autobleem2/ableemstation/files/stickers/special/ableemstation-stickers-A4.pdf

ABleemStation stickers - print at 100% (no "fit to page"), vinyl sticker sheet; cut on the dashed lines. Check: the top plate must measure 61 mm.

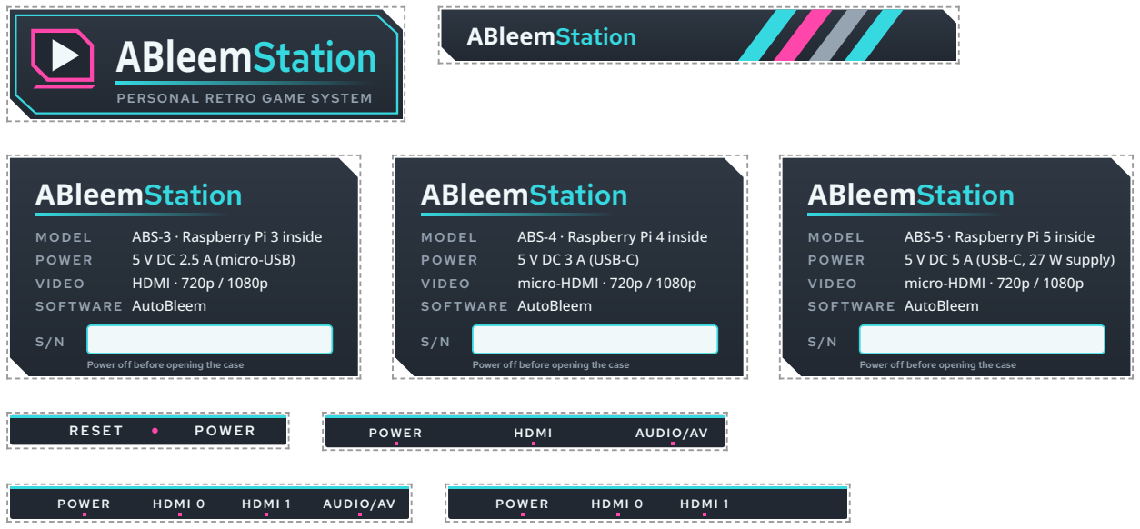
[picture p5: figure]
ABleemStation; PERSONAL RETRO GAME SYSTEM; ABS-3 · Raspberry Pi 3 inside; P OWER; 5 V DC 2.5 A (micro-USB); HDMI · 720p / 1080p; S O FTWA RE AutoBleem; Power off before opening the case; ABS-4 · Raspberry Pi 4 inside; 5 V DC 3 A (USB-C); micro-HDMI · 720p / 1080p; ABS-5 · Raspberry Pi 5 inside; 5 V DC 5 A (USB-C, 27 W supply); POWER; HDMI; AUDIO/AV; HDMI 0; HDMI 1

# ABleemStation

SPECIAL EDITION · RETRO GAME SYSTEM

## ABleemStation

# ABleemStation

M O D EL | ABS-3 · Raspberry Pi 3 inside
P OWER | 5 V DC 2.5 A (micro-USB)
V I D EO | HDMI · 720p / 1080p
S O FTWA RE AutoBleem

S/N

Power off before opening the case

# ABleemStation

M O D EL | ABS-4 · Raspberry Pi 4 inside
P OWER | 5 V DC 3 A (USB-C)
V I D EO | micro-HDMI · 720p / 1080p
S O FTWA RE AutoBleem

S/N

Power off before opening the case

# ABleemStation

M O D EL | ABS-5 · Raspberry Pi 5 inside
P OWER | 5 V DC 5 A (USB-C, 27 W supply)
V I D EO | micro-HDMI · 720p / 1080p
S O FTWA RE AutoBleem

S/N

Power off before opening the case

RE S E T | P OW ER | POWER | HDMI | AUDIO/AV
POWER | HDMI 0 | HDMI 1 | AUDIO/AV | POWER | HDMI 0 | HDMI 1
