autobleem2/ableemstation/files/renders/1-iso.png

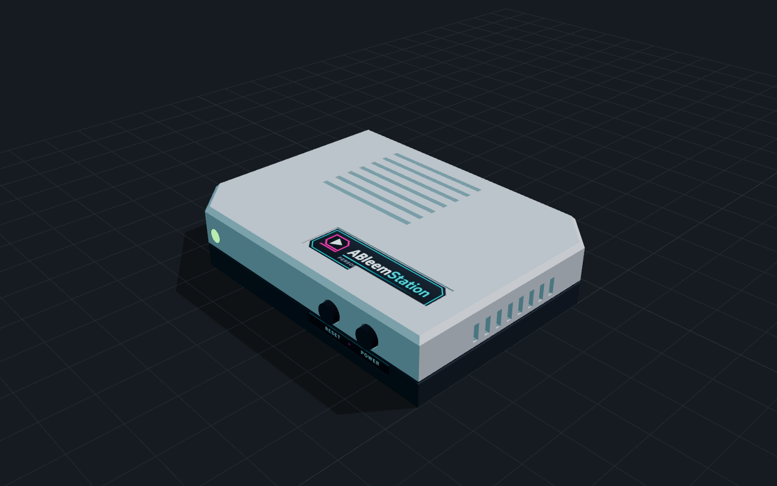
files/renders/1-iso.png
