autobleem2/ableemstation/files/renders/2-front.png

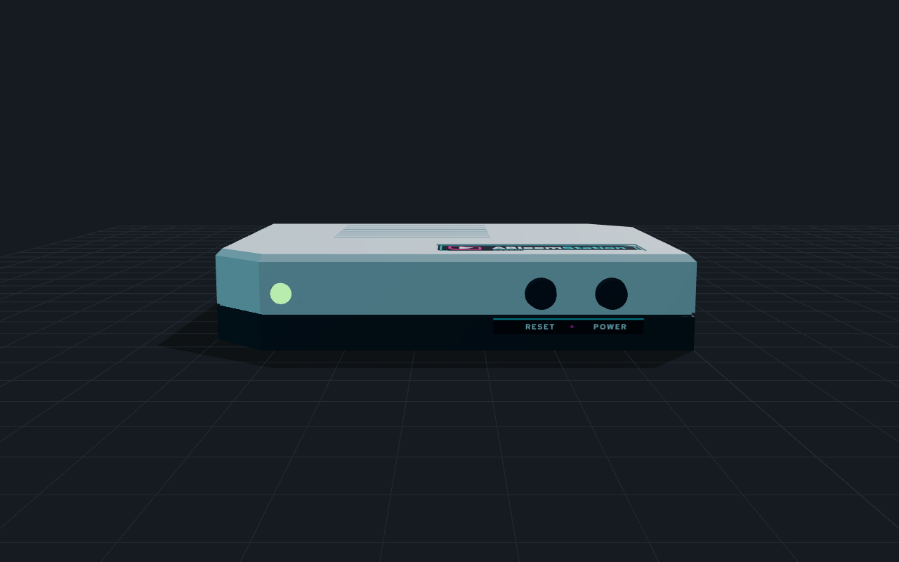
files/renders/2-front.png
