autobleem2/ableemstation/files/renders/4-right.png

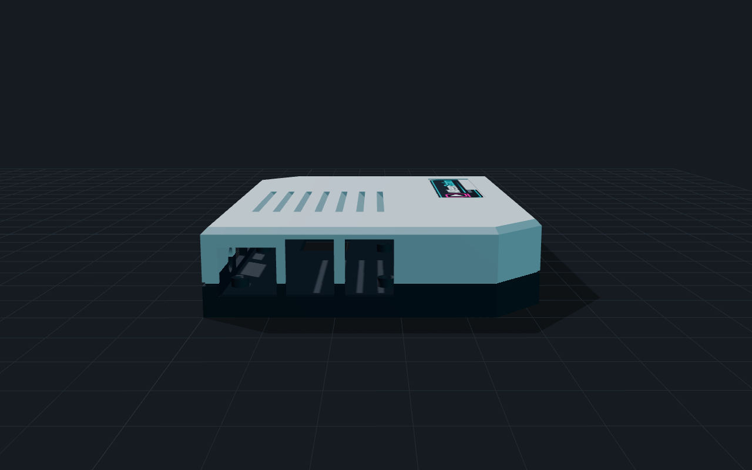
files/renders/4-right.png
