autobleem2/ableemstation/files/renders/5-exploded.png

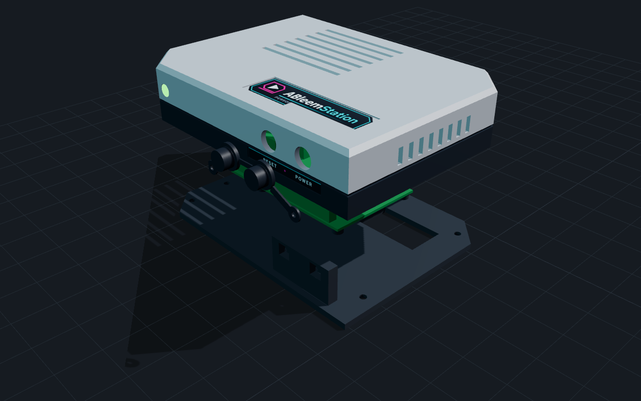
files/renders/5-exploded.png
