autobleem2/ableemstation/files/renders/6-xray.png

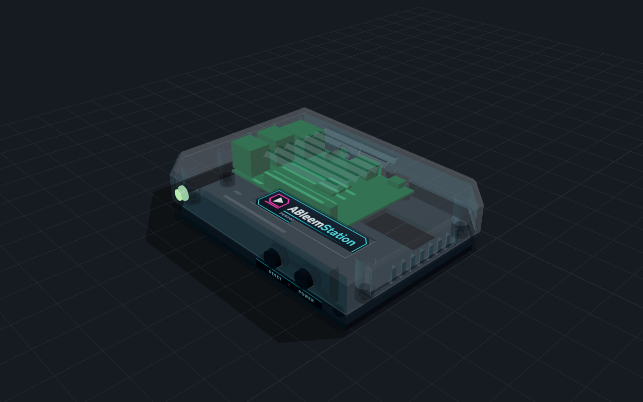
files/renders/6-xray.png
