autobleem2/ableemstation/files/renders/colors/graphite.png

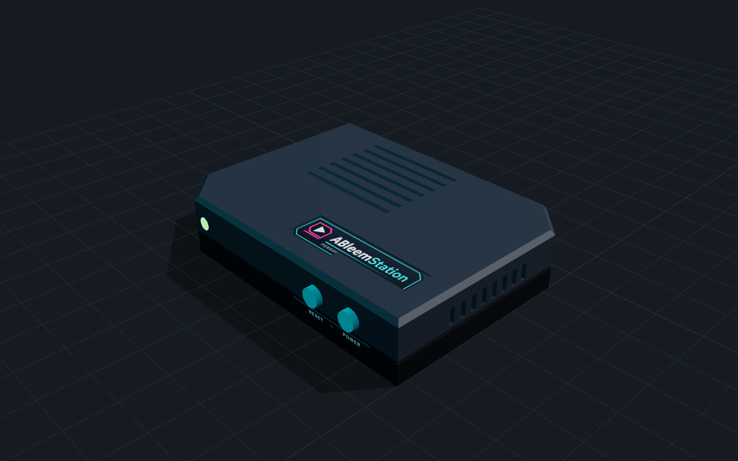
files/renders/colors/graphite.png
