autobleem2/ableemstation/files/renders/colors/midnight.png

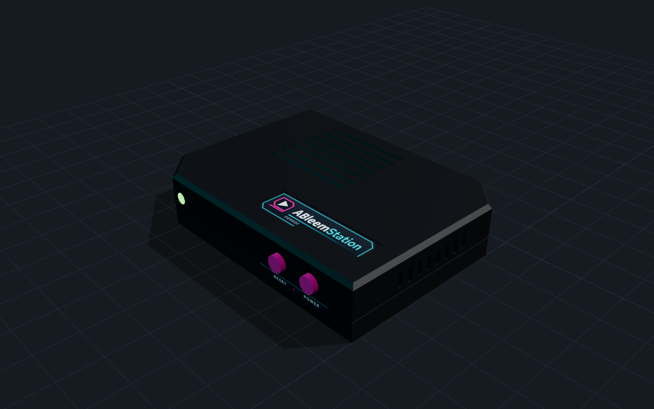
files/renders/colors/midnight.png
