autobleem2/ableemstation/files/renders/colors/mint.png

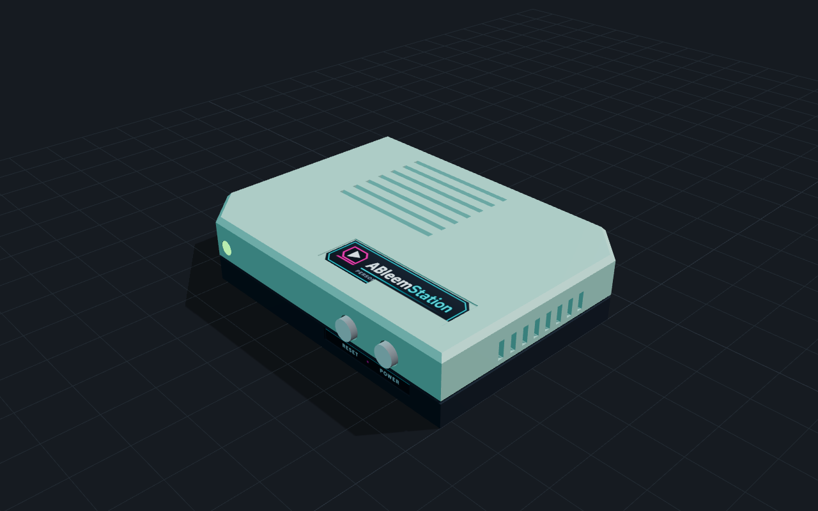
files/renders/colors/mint.png
