autobleem2/ableemstation/files/stickers/cricut-144dpi/ableemstation-all-stickers.png

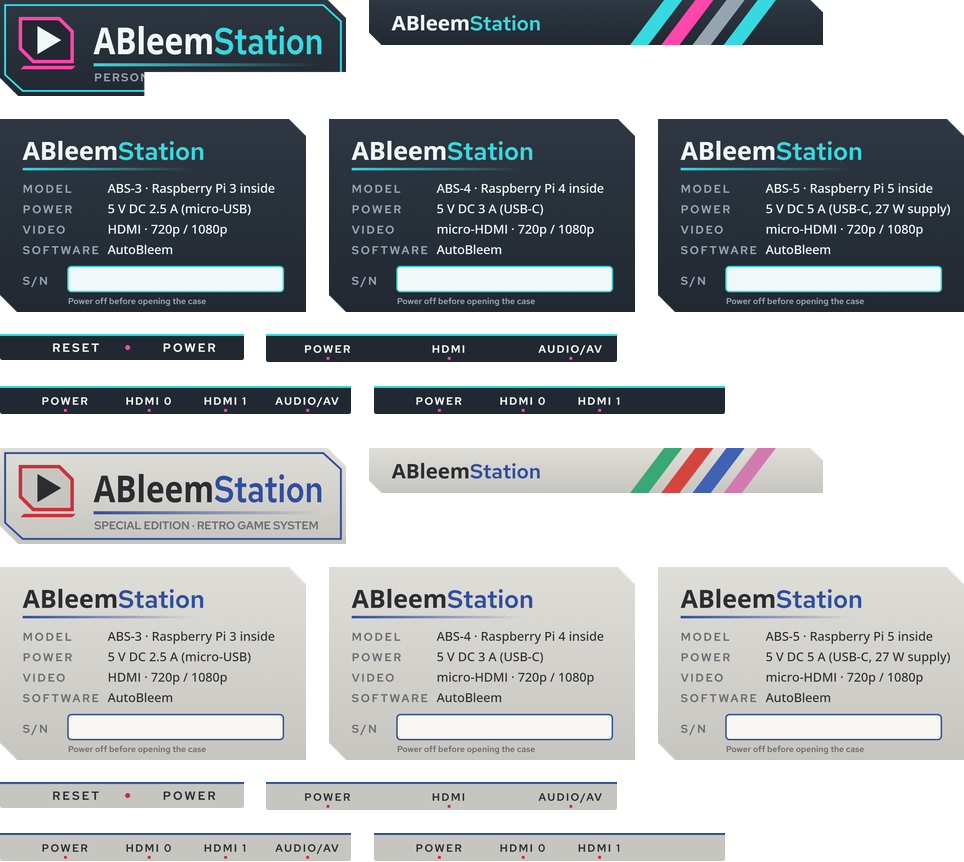
files/stickers/cricut-144dpi/ableemstation-all-stickers.png
