autobleem2/ableemstation/files/stickers/sticker-top.png

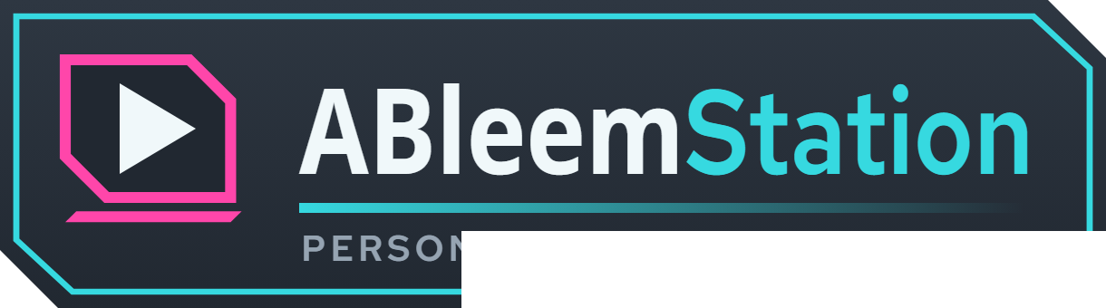
files/stickers/sticker-top.png
