autobleem2/ableemstation/files/universal/renders/8-exploded.png

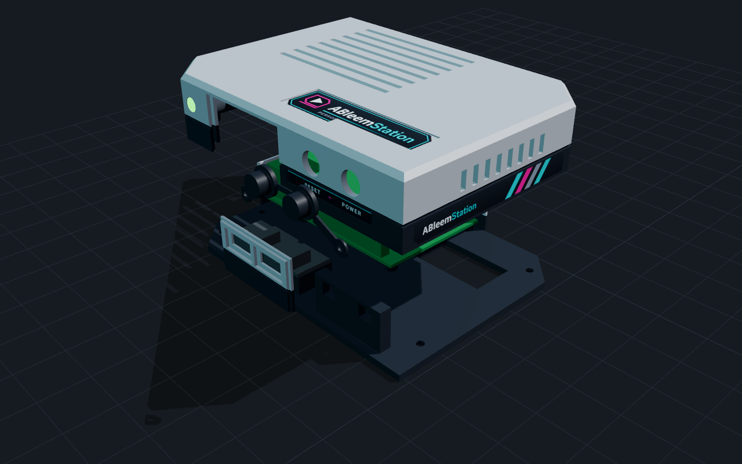
files/universal/renders/8-exploded.png
