autobleem2/ableemstation/files/universal/renders/10-top-active.png

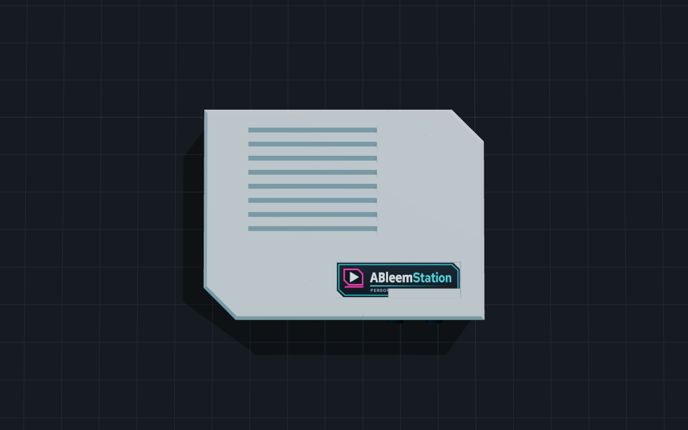
files/universal/renders/10-top-active.png
