autobleem2/ableemstation/files/universal/renders/12-bottom-sticker.png

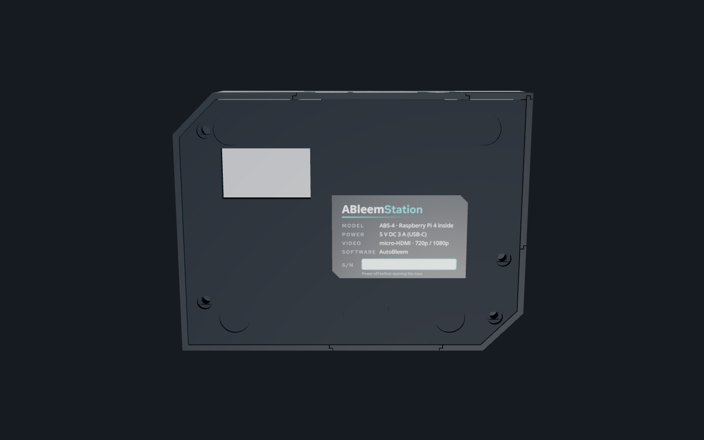
files/universal/renders/12-bottom-sticker.png
