autobleem2/ableemstation/files/universal/sticker-placement.png

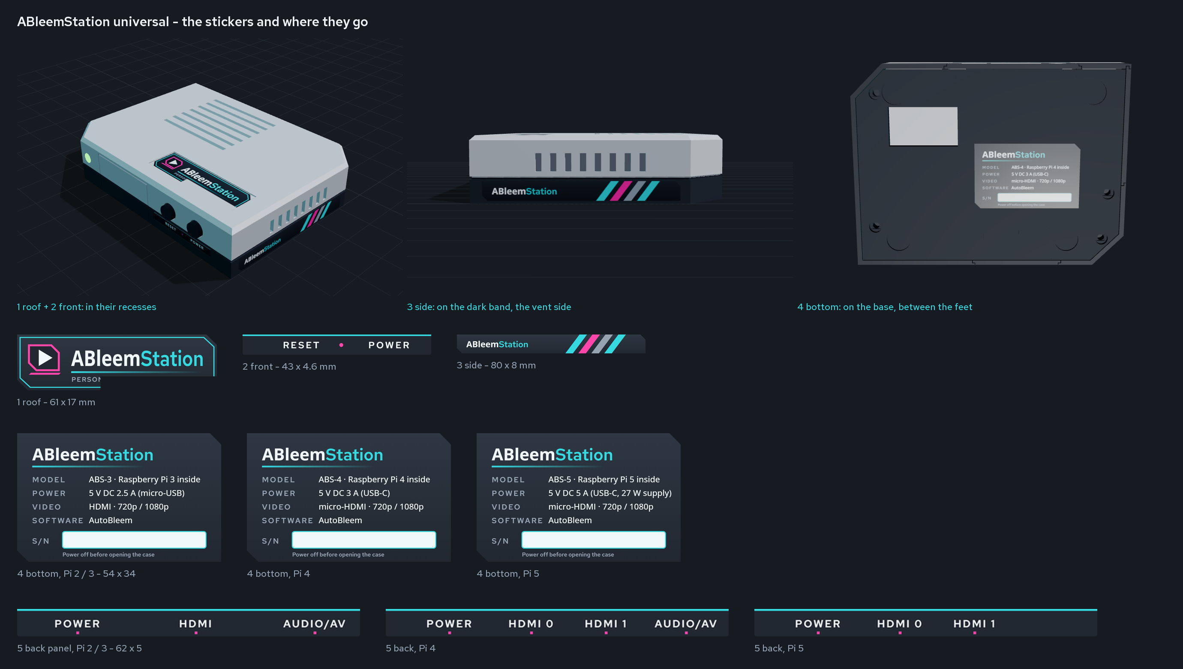
files/universal/sticker-placement.png
