autobleem2/ableemstation/files/ableemstation-assembly.step

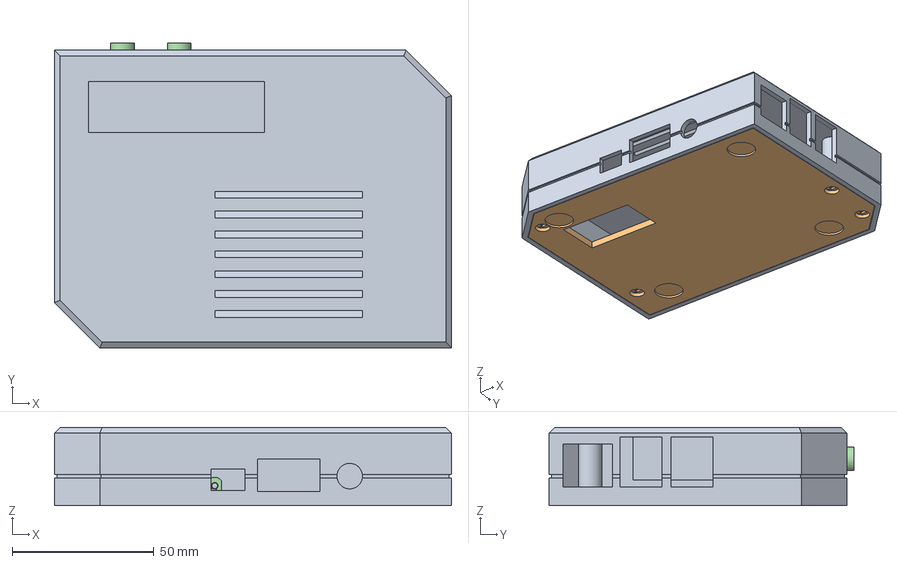
[picture p20: CAD file, 2026-10-09]
files/ableemstation-assembly.step
140.0 x 107.5 x 27.6 mm
