autobleem2/ableemstation/files/universal/ableemstation-uni-shell-active.step

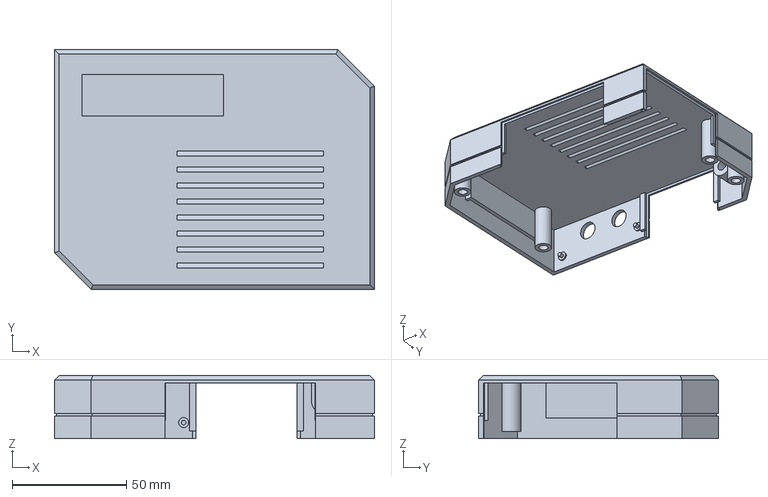
[picture p22: CAD file, 2026-10-09]
files/universal/ableemstation-uni-shell-active.step
140.0 x 105.0 x 27.6 mm
