autobleem2/ableemstation/files/universal/viewer/base.stl

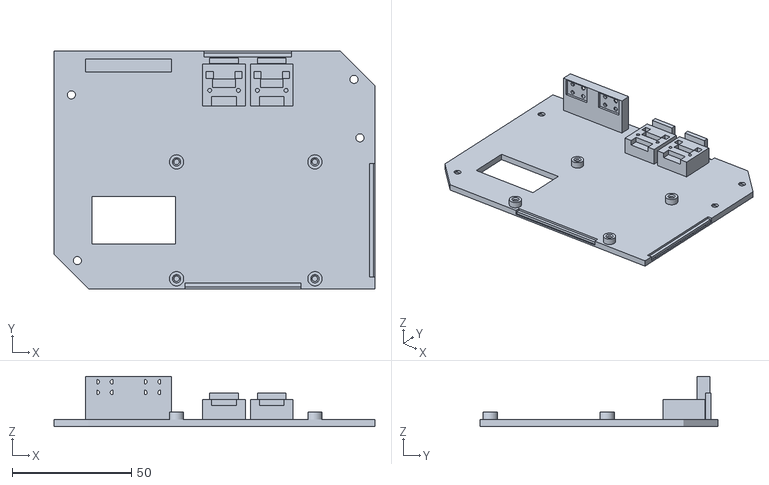
[picture p23: CAD file, 2026-10-09]
files/universal/viewer/base.stl
134.6 x 99.6 x 21.0
