autobleem2/ableemstation/files/viewer/base.stl

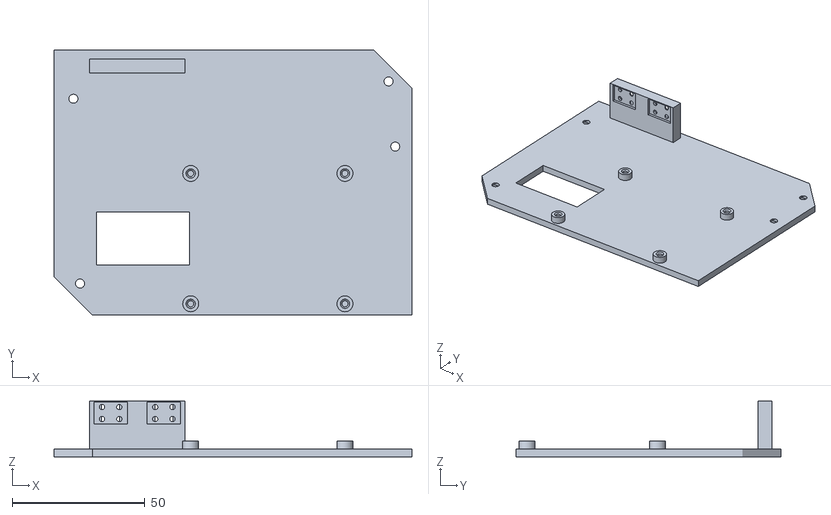
[picture p24: CAD file, 2026-10-09]
files/viewer/base.stl
134.6 x 99.6 x 21.0
