autobleem2/ableemstation/files/universal/ableemstation-panel-right-pi4-front.step

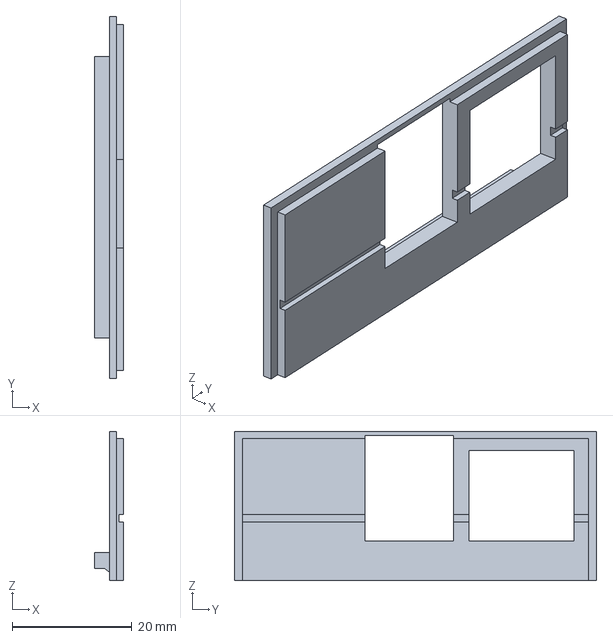
[picture p25: CAD file, 2026-10-09]
files/universal/ableemstation-panel-right-pi4-front.step
4.90 x 60.5 x 24.9 mm
