autobleem2/ableemstation/files/viewer/shell.stl

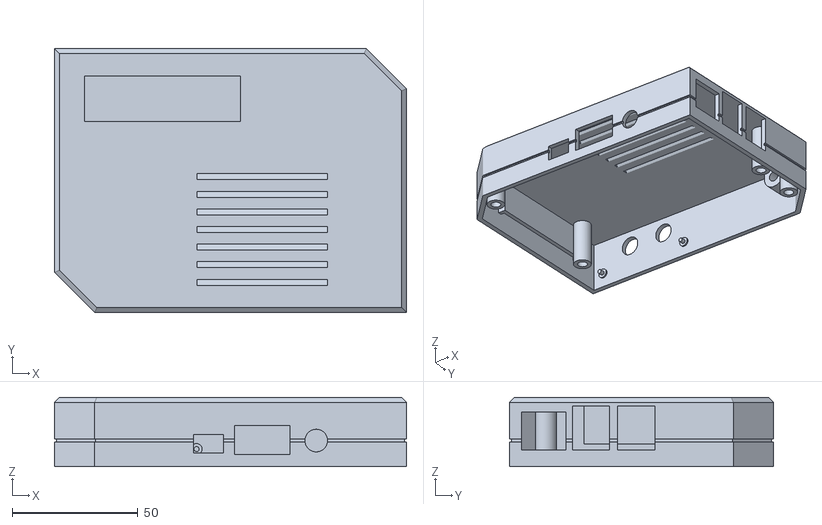
[picture p27: CAD file, 2026-10-09]
files/viewer/shell.stl
140.0 x 105.0 x 27.6
