autobleem2/ableemstation/files/ableemstation-lens.step

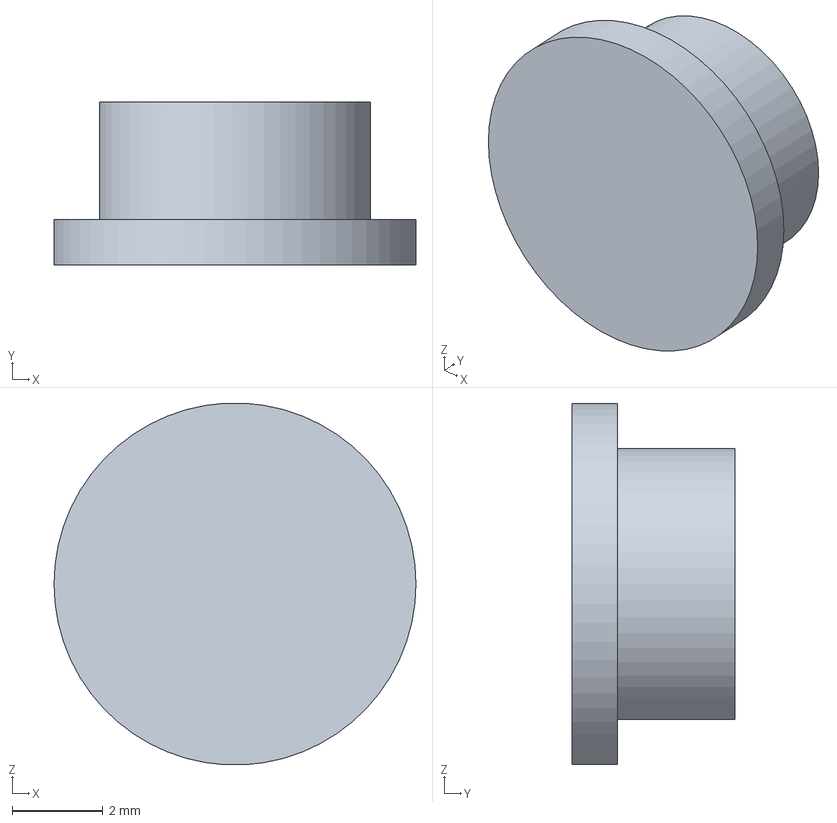
[picture p28: CAD file, 2026-10-09]
files/ableemstation-lens.step
8.00 x 3.60 x 7.99 mm
