autobleem2/ableemstation/files/universal/ableemstation-panel-front-usb.step

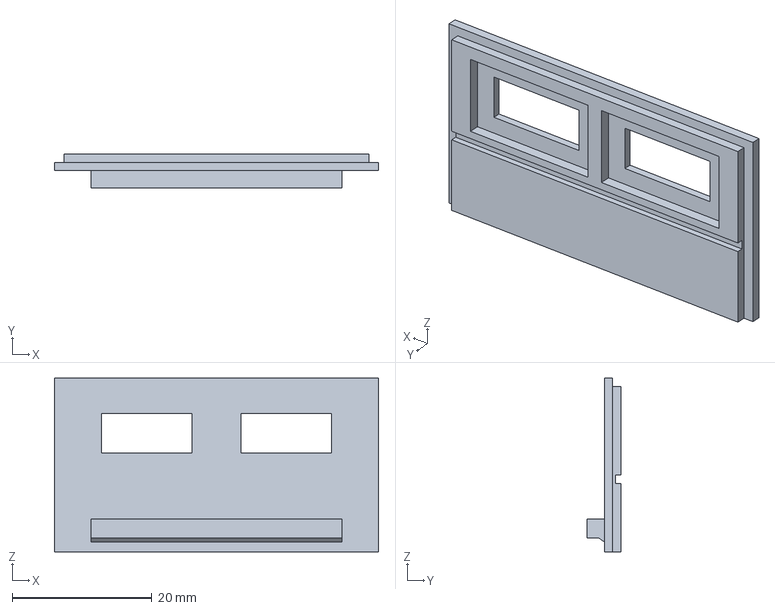
[picture p29: CAD file, 2026-10-09]
files/universal/ableemstation-panel-front-usb.step
46.4 x 4.90 x 24.9 mm
