autobleem2/ableemstation/files/universal/viewer/front-blank.stl

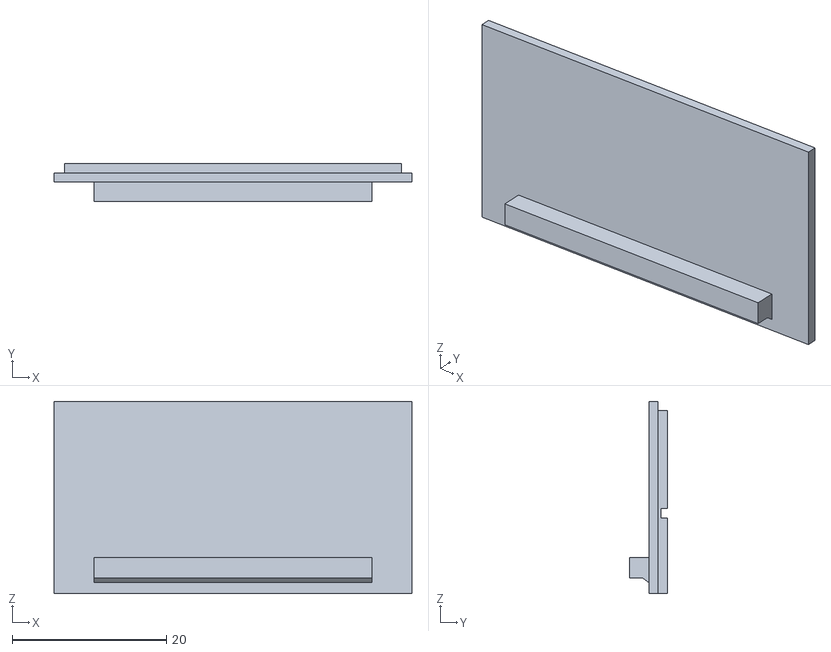
[picture p30: CAD file, 2026-10-09]
files/universal/viewer/front-blank.stl
46.4 x 4.90 x 24.9
