autobleem2/ableemstation/files/viewer/caps.stl

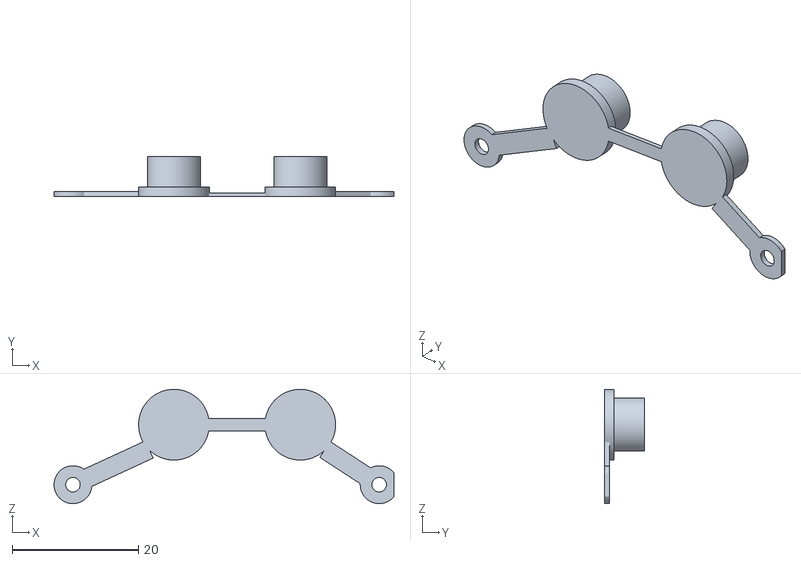
[picture p31: CAD file, 2026-10-09]
files/viewer/caps.stl
53.8 x 6.40 x 18.1
