autobleem2/ableemstation/files/universal/ableemstation-panel-back-pi23.step

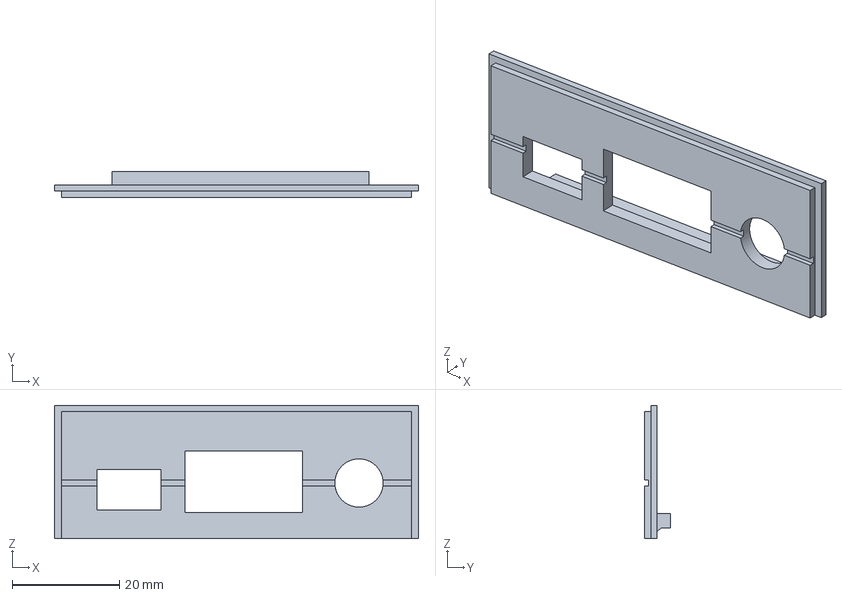
[picture p32: CAD file, 2026-10-09]
files/universal/ableemstation-panel-back-pi23.step
67.9 x 4.90 x 24.9 mm
