autobleem2/ableemstation/files/ableemstation-all-parts.3mf

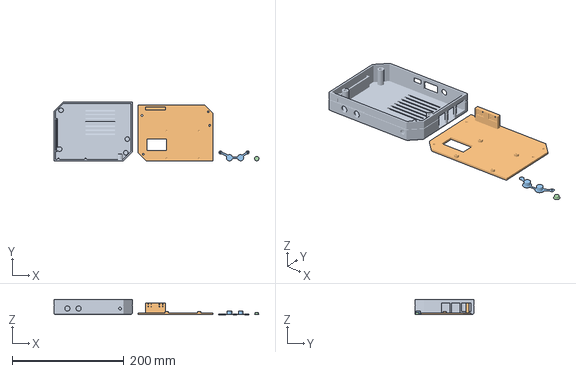
[picture p33: CAD file, 2026-10-09]
files/ableemstation-all-parts.3mf
366.5 x 105.0 x 27.6 mm
