autobleem2/ableemstation/files/universal/ableemstation-uni-bottom-pi4-usb-open.3mf

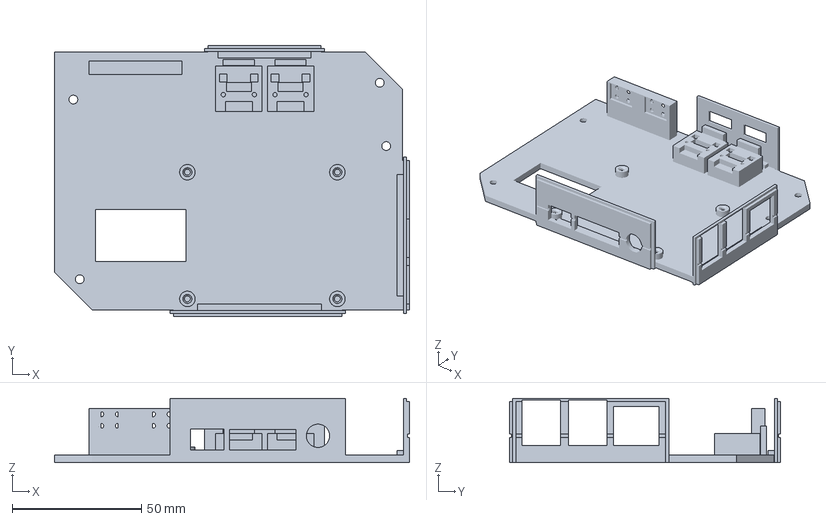
[picture p34: CAD file, 2026-10-09]
files/universal/ableemstation-uni-bottom-pi4-usb-open.3mf
137.3 x 105.0 x 24.9 mm
