autobleem2/ableemstation/files/universal/viewer/set-pi23.stl

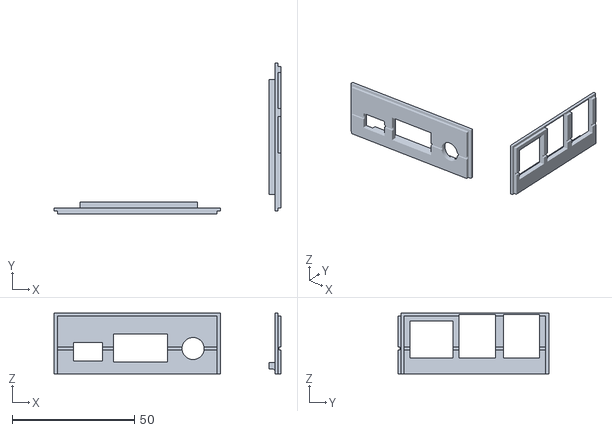
[picture p35: CAD file, 2026-10-09]
files/universal/viewer/set-pi23.stl
92.7 x 61.7 x 24.9
