autobleem2/ableemstation/files/viewer/pi.stl

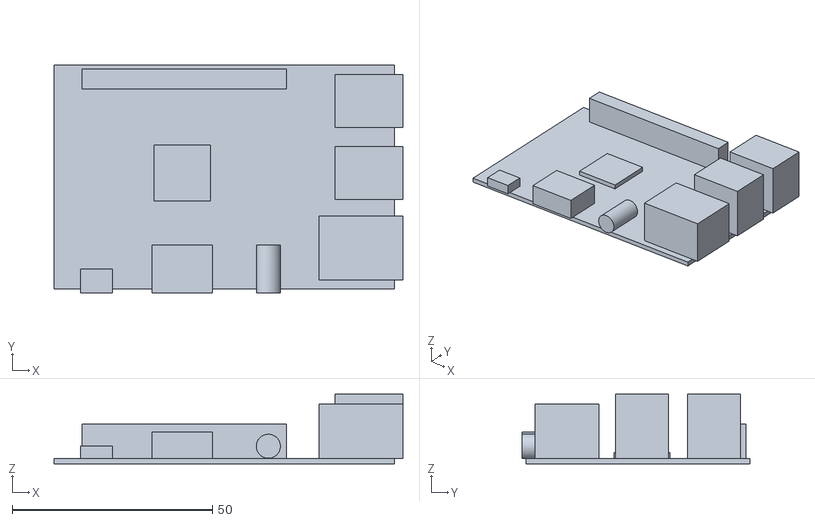
[picture p36: CAD file, 2026-10-09]
files/viewer/pi.stl
87.1 x 57.0 x 17.4
