autobleem2/ableemstation/files/universal/ableemstation-uni-shell-rgb.step

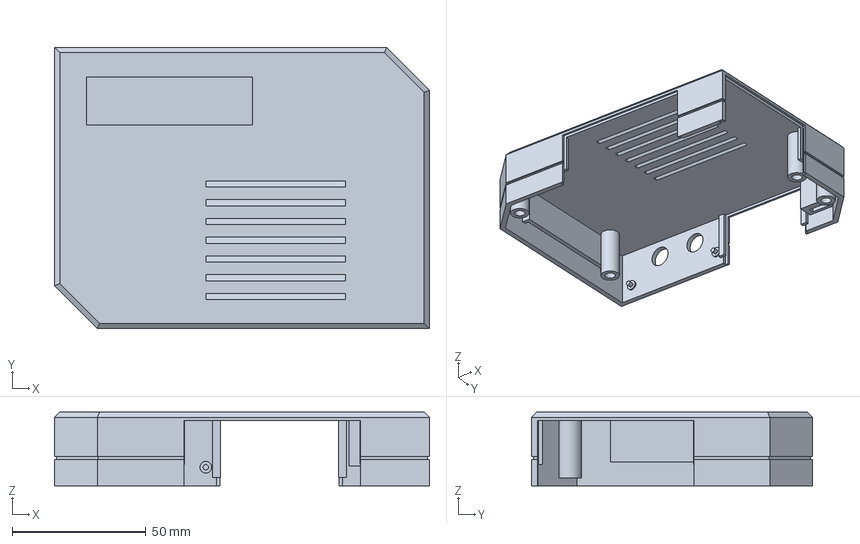
[picture p37: CAD file, 2026-10-09]
files/universal/ableemstation-uni-shell-rgb.step
140.0 x 105.0 x 27.6 mm
