autobleem2/ableemstation/files/universal/viewer/set-pi5.stl

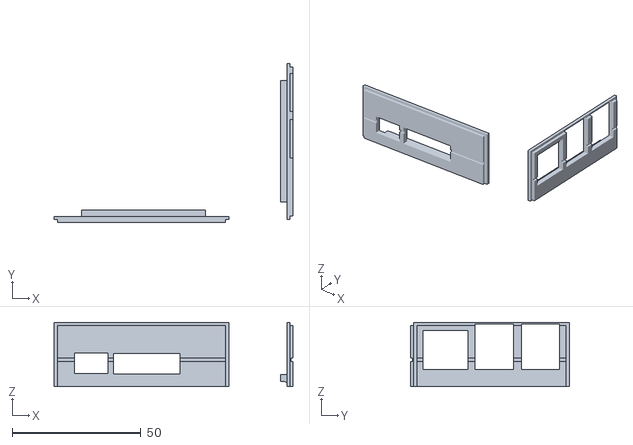
[picture p38: CAD file, 2026-10-09]
files/universal/viewer/set-pi5.stl
92.7 x 61.7 x 24.9
