autobleem2/ableemstation/files/universal/ableemstation-panel-back-pi4.step

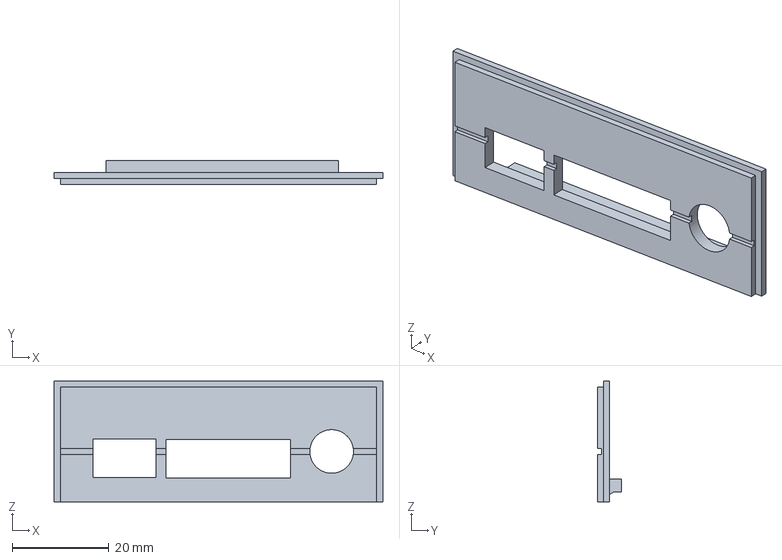
[picture p41: CAD file, 2026-10-09]
files/universal/ableemstation-panel-back-pi4.step
67.9 x 4.90 x 24.9 mm
