autobleem2/ableemstation/files/universal/viewer/pi-pi5.stl

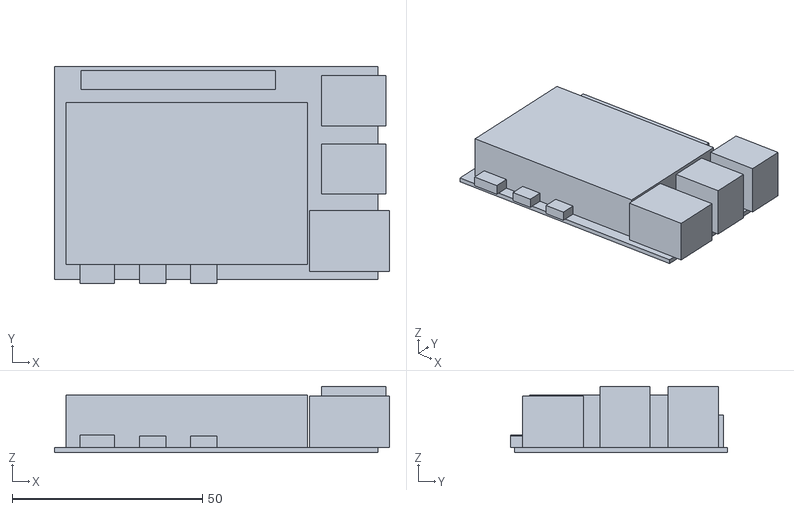
[picture p42: CAD file, 2026-10-09]
files/universal/viewer/pi-pi5.stl
88.0 x 57.0 x 17.4
