autobleem2/ableemstation/files/universal/viewer/usb-sockets.stl

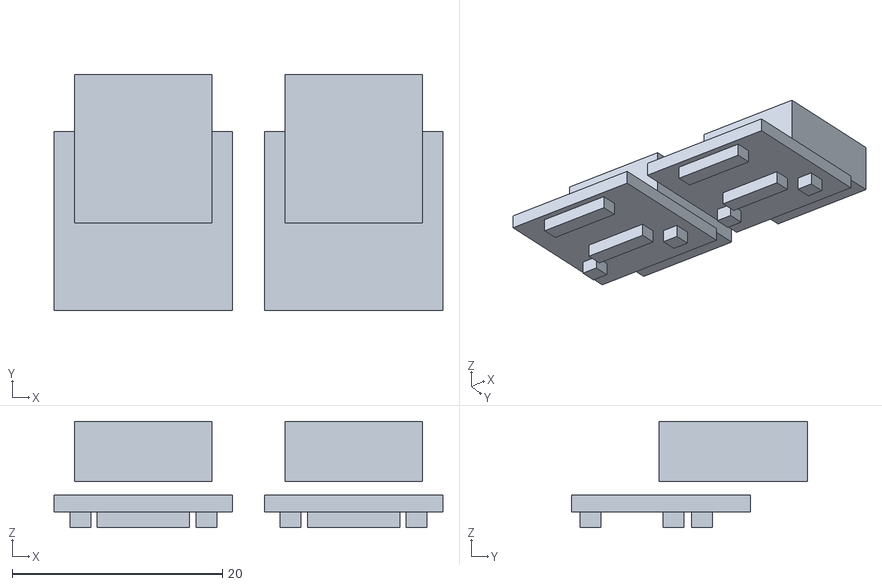
[picture p43: CAD file, 2026-10-09]
files/universal/viewer/usb-sockets.stl
37.0 x 22.4 x 10.1
