autobleem2/ableemstation/files/universal/ableemstation-panel-right-blank.step

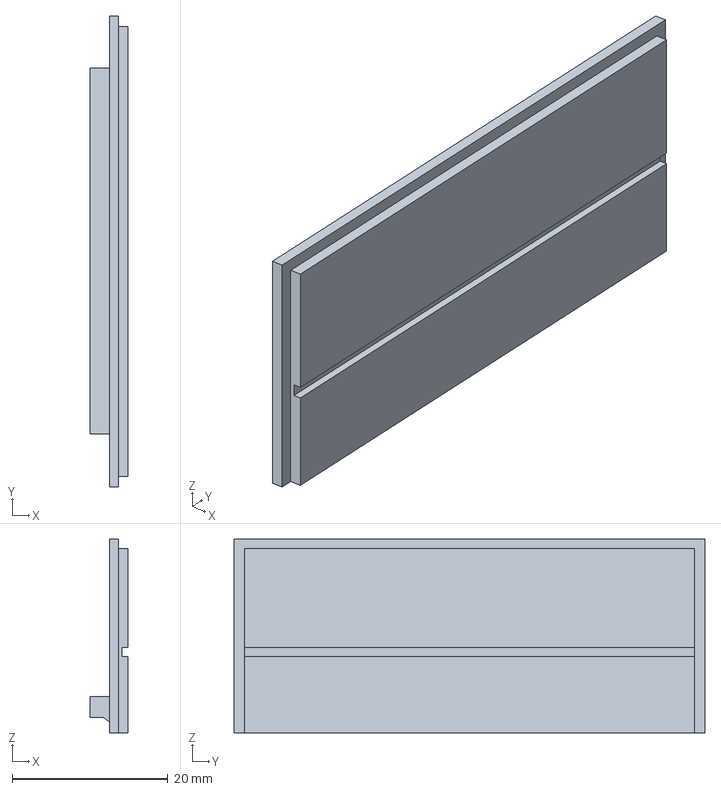
[picture p44: CAD file, 2026-10-09]
files/universal/ableemstation-panel-right-blank.step
4.90 x 60.5 x 24.9 mm
