autobleem2/ableemstation/files/universal/ableemstation-panels-all.3mf

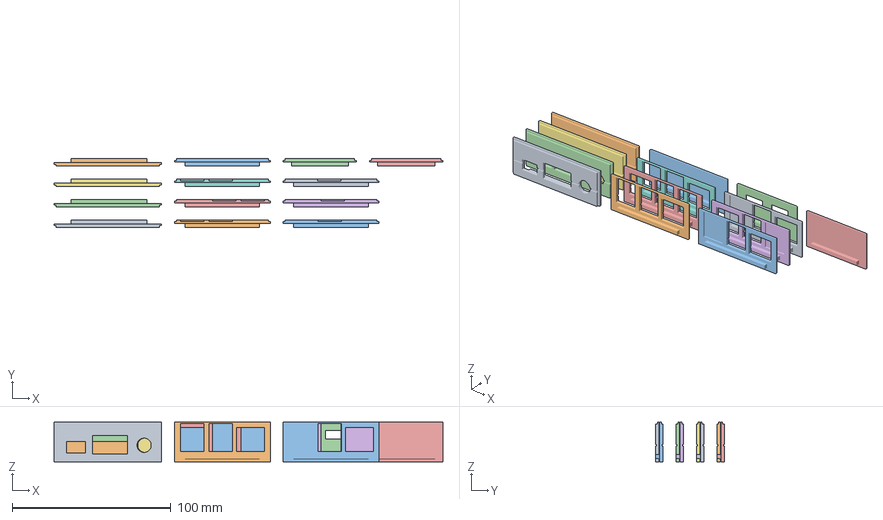
[picture p46: CAD file, 2026-10-09]
files/universal/ableemstation-panels-all.3mf
245.2 x 43.6 x 24.9 mm
