autobleem2/ableemstation/(list of files, cad)

Other CAD files:
files/ableemstation-base.step
files/universal/viewer/front-usb.stl
files/viewer/shell-rgb.stl
files/ableemstation-shell.step
files/universal/viewer/set-pi4.stl
files/viewer/lens.stl
files/ableemstation-buttons.step
files/universal/ableemstation-panel-right-pi23-front.step
files/ableemstation-shell-rgb.step
files/universal/ableemstation-uni-bottom-pi5-usb.3mf
files/universal/viewer/set-pi4-front.stl
files/universal/viewer/lens.stl
files/universal/ableemstation-uni-bottom-pi23-usb.3mf
files/universal/viewer/shell.stl
files/universal/ableemstation-uni-bottom-pi4-usb.3mf
files/universal/ableemstation-uni-shell-active-rgb.step
files/universal/viewer/shell-active-rgb.stl
files/universal/ableemstation-uni-bottom-pi23-blank.3mf
files/universal/viewer/pi-pi4.stl
files/universal/ableemstation-uni-bottom-pi5-usb-open.3mf
files/universal/ableemstation-uni-bottom-pi23-usb-open.3mf
files/universal/viewer/shell-rgb.stl
files/universal/ableemstation-panel-right-pi4.step
files/universal/viewer/shell-active.stl
files/universal/ableemstation-uni-shell.step
files/universal/viewer/pi-pi23.stl
files/universal/ableemstation-uni-bottom-pi4-blank.3mf
files/universal/ableemstation-panel-front-blank.step
files/universal/ableemstation-panel-back-pi5.step
files/universal/ableemstation-panel-right-pi23.step
files/universal/ableemstation-uni-bottom-pi5-blank.3mf
files/universal/ableemstation-uni-base.step
files/universal/ableemstation-panel-right-pi5-front.step
files/ableemstation-base.3mf
files/ableemstation-base.stl
files/ableemstation-buttons.3mf
files/ableemstation-buttons.stl
files/ableemstation-lens.3mf
files/ableemstation-lens.stl
files/ableemstation-shell-rgb.3mf
files/ableemstation-shell-rgb.stl
files/ableemstation-shell.3mf
files/ableemstation-shell.stl
files/universal/ableemstation-panel-back-blank.3mf
files/universal/ableemstation-panel-back-blank.stl
files/universal/ableemstation-panel-back-pi23.3mf
files/universal/ableemstation-panel-back-pi23.stl
files/universal/ableemstation-panel-back-pi4.3mf
files/universal/ableemstation-panel-back-pi4.stl
files/universal/ableemstation-panel-back-pi5.3mf
files/universal/ableemstation-panel-back-pi5.stl
files/universal/ableemstation-panel-front-blank.3mf
files/universal/ableemstation-panel-front-usb.3mf
files/universal/ableemstation-panel-front-usb.stl
files/universal/ableemstation-panel-right-blank.3mf
files/universal/ableemstation-panel-right-blank.stl
files/universal/ableemstation-panel-right-pi23-front.3mf
files/universal/ableemstation-panel-right-pi23-front.stl
files/universal/ableemstation-panel-right-pi23.3mf
files/universal/ableemstation-panel-right-pi23.stl
files/universal/ableemstation-panel-right-pi4-front.3mf
files/universal/ableemstation-panel-right-pi4-front.stl
files/universal/ableemstation-panel-right-pi4.3mf
files/universal/ableemstation-panel-right-pi4.stl
files/universal/ableemstation-panel-right-pi5-front.3mf
files/universal/ableemstation-panel-right-pi5-front.stl
files/universal/ableemstation-panel-right-pi5.3mf
files/universal/ableemstation-panel-right-pi5.stl
files/universal/ableemstation-uni-base.3mf
files/universal/ableemstation-uni-base.stl
files/universal/ableemstation-uni-shell-active-rgb.3mf
files/universal/ableemstation-uni-shell-active-rgb.stl
files/universal/ableemstation-uni-shell-active.3mf
files/universal/ableemstation-uni-shell-active.stl
files/universal/ableemstation-uni-shell-rgb.3mf
files/universal/ableemstation-uni-shell-rgb.stl
files/universal/ableemstation-uni-shell.3mf
files/universal/ableemstation-uni-shell.stl
