autobleem2/ableemstation/(commit log)

2026-10-09 ABleemStation - Open Source Retro Gaming Console (draft)
    [ableemstation-all-parts-rgb.3mf, ableemstation-all-parts.3mf, ableemstation-assembly.step, ableemstation-base.3mf, ableemstation-base.step, ableemstation-base.stl, ableemstation-buttons.3mf, ableemstation-buttons.step]
2026-10-09 Switch pockets 6.8 mm, leg holes 2.0 mm; switch fit coupon
    [ableemstation-all-parts-rgb.3mf, ableemstation-all-parts.3mf, ableemstation-assembly.step, ableemstation-base.3mf, ableemstation-base.step, ableemstation-base.stl, ableemstation-buttons.3mf, ableemstation-buttons.step]
2026-10-09 Panels: TOP_GAP 0.45 so printed panels do not prop the shell
    [ableemstation-all-parts-rgb.3mf, ableemstation-all-parts.3mf, ableemstation-assembly.step, ableemstation-base.3mf, ableemstation-base.step, ableemstation-buttons.3mf, ableemstation-buttons.step, ableemstation-lens.3mf]
2026-10-09 README: switch coupon row in the Checks table
2026-10-09 Panels: TOP_GAP 0.70 (test print: shell lifted 0.5-0.6 mm at the rear USB corner)
    [ableemstation-all-parts-rgb.3mf, ableemstation-all-parts.3mf, ableemstation-assembly.step, ableemstation-base.3mf, ableemstation-base.step, ableemstation-buttons.3mf, ableemstation-buttons.step, ableemstation-lens.3mf]
2026-10-09 Drop the breakaway ears and tab props (panels are printed fused to the base); rebuilt files
    [ableemstation-all-parts-rgb.3mf, ableemstation-all-parts.3mf, ableemstation-assembly.step, ableemstation-base.3mf, ableemstation-base.step, ableemstation-buttons.3mf, ableemstation-buttons.step, ableemstation-lens.3mf]
2026-10-09 Switch pockets 6.96 x 6.47 (measured 6.51 x 6.02), rear well round each switch (0.6 mm wall) so the legs can be bent and soldered
    [ableemstation-all-parts-rgb.3mf, ableemstation-all-parts.3mf, ableemstation-assembly.step, ableemstation-base.3mf, ableemstation-base.step, ableemstation-base.stl, ableemstation-buttons.3mf, ableemstation-buttons.step]
2026-10-09 Switch pockets 6.70 x 6.25 (coupon 2: printed 6.90 x 6.35, loose), rear well 3 mm wider in x for bending the legs outward
    [ableemstation-all-parts-rgb.3mf, ableemstation-all-parts.3mf, ableemstation-assembly.step, ableemstation-base.3mf, ableemstation-base.step, ableemstation-base.stl, ableemstation-buttons.3mf, ableemstation-buttons.step]
2026-10-09 README: switch pocket size and rear well
